LeaveryF/rv-cpu-expr/MemExt/rv32icpu.srcs/constrs_1/new/top_alu.xdc

set_property PACKAGE_PIN P28 [get_ports { A[7] }]
set_property IOSTANDARD LVCMOS18 [get_ports { A[7] }]
set_property PACKAGE_PIN P27 [get_ports { A[6] }]
set_property IOSTANDARD LVCMOS18 [get_ports { A[6] }]
set_property PACKAGE_PIN P26 [get_ports { A[5] }]
set_property IOSTANDARD LVCMOS18 [get_ports { A[5] }]
set_property PACKAGE_PIN T23 [get_ports { A[4] }]
set_property IOSTANDARD LVCMOS18 [get_ports { A[4] }]
set_property PACKAGE_PIN W23 [get_ports { A[3] }]
set_property IOSTANDARD LVCMOS18 [get_ports { A[3] }]
set_property PACKAGE_PIN T22 [get_ports { A[2] }]
set_property IOSTANDARD LVCMOS18 [get_ports { A[2] }]
set_property PACKAGE_PIN U22 [get_ports { A[1] }]
set_property IOSTANDARD LVCMOS18 [get_ports { A[1] }]
set_property PACKAGE_PIN T21 [get_ports { A[0] }]
set_property IOSTANDARD LVCMOS18 [get_ports { A[0] }]
set_property PACKAGE_PIN T27 [get_ports { B[7] }]
set_property IOSTANDARD LVCMOS18 [get_ports { B[7] }]
set_property PACKAGE_PIN T26 [get_ports { B[6] }]
set_property IOSTANDARD LVCMOS18 [get_ports { B[6] }]
set_property PACKAGE_PIN T25 [get_ports { B[5] }]
set_property IOSTANDARD LVCMOS18 [get_ports { B[5] }]
set_property PACKAGE_PIN R30 [get_ports { B[4] }]
set_property IOSTANDARD LVCMOS18 [get_ports { B[4] }]
set_property PACKAGE_PIN R29 [get_ports { B[3] }]
set_property IOSTANDARD LVCMOS18 [get_ports { B[3] }]
set_property PACKAGE_PIN R28 [get_ports { B[2] }]
set_property IOSTANDARD LVCMOS18 [get_ports { B[2] }]
set_property PACKAGE_PIN R26 [get_ports { B[1] }]
set_property IOSTANDARD LVCMOS18 [get_ports { B[1] }]
set_property PACKAGE_PIN P29 [get_ports { B[0] }]
set_property IOSTANDARD LVCMOS18 [get_ports { B[0] }]
set_property PACKAGE_PIN T30 [get_ports { ALUControl[1] }]
set_property IOSTANDARD LVCMOS18 [get_ports { ALUControl[1] }]
set_property PACKAGE_PIN T28 [get_ports { ALUControl[0] }]
set_property IOSTANDARD LVCMOS18 [get_ports { ALUControl[0] }]
set_property PACKAGE_PIN E29 [get_ports { Result[7] }]
set_property IOSTANDARD LVCMOS18 [get_ports { Result[7] }]
set_property PACKAGE_PIN G25 [get_ports { Result[6] }]
set_property IOSTANDARD LVCMOS18 [get_ports { Result[6] }]
set_property PACKAGE_PIN F26 [get_ports { Result[5] }]
set_property IOSTANDARD LVCMOS18 [get_ports { Result[5] }]
set_property PACKAGE_PIN C26 [get_ports { Result[4] }]
set_property IOSTANDARD LVCMOS18 [get_ports { Result[4] }]
set_property PACKAGE_PIN E25 [get_ports { Result[3] }]
set_property IOSTANDARD LVCMOS18 [get_ports { Result[3] }]
set_property PACKAGE_PIN C24 [get_ports { Result[2] }]
set_property IOSTANDARD LVCMOS18 [get_ports { Result[2] }]
set_property PACKAGE_PIN E24 [get_ports { Result[1] }]
set_property IOSTANDARD LVCMOS18 [get_ports { Result[1] }]
set_property PACKAGE_PIN G24 [get_ports { Result[0] }]
set_property IOSTANDARD LVCMOS18 [get_ports { Result[0] }]
set_property PACKAGE_PIN G23 [get_ports { N }]
set_property IOSTANDARD LVCMOS18 [get_ports { N }]
set_property PACKAGE_PIN E23 [get_ports { Z }]
set_property IOSTANDARD LVCMOS18 [get_ports { Z }]
set_property PACKAGE_PIN D24 [get_ports { V }]
set_property IOSTANDARD LVCMOS18 [get_ports { V }]
set_property PACKAGE_PIN C25 [get_ports { C }]
set_property IOSTANDARD LVCMOS18 [get_ports { C }]

set_property CLOCK_DEDICATED_ROUTE FALSE [get_nets ALUControl[1]]
