LeaveryF/rv-cpu-expr/alu/rv32icpu.srcs/sources_1/new/adder.sv

`timescale 1ns / 1ps
//////////////////////////////////////////////////////////////////////////////////
// Company: 
// Engineer: 
// 
// Create Date: 02/19/2025 11:28:42 AM
// Design Name: 
// Module Name: adder
// Project Name: 
// Target Devices: 
// Tool Versions: 
// Description: 
// 
// Dependencies: 
// 
// Revision:
// Revision 0.01 - File Created
// Additional Comments:
// 
//////////////////////////////////////////////////////////////////////////////////


module adder(
    input  logic a,
    input  logic b,
    input  logic cin,
    output logic sum,
    output logic cout
);
endmodule
