LeaveryF/rv-cpu-expr/alu/rv32icpu.srcs/sources_1/new/multipler32.sv

`timescale 1ns / 1ps
//////////////////////////////////////////////////////////////////////////////////
// Company: 
// Engineer: 
// 
// Create Date: 02/19/2025 11:18:46 AM
// Design Name: 
// Module Name: multipler32
// Project Name: 
// Target Devices: 
// Tool Versions: 
// Description: 
// 
// Dependencies: 
// 
// Revision:
// Revision 0.01 - File Created
// Additional Comments:
// 
//////////////////////////////////////////////////////////////////////////////////


module multipler32(
    input  logic [31:0] a,
    input  logic [31:0] b,
    output logic [63:0] p
);
endmodule
