LeaveryF/rv-cpu-expr/(commit log)

2026-06-15 verification task
    [图5-11 miniRV-1指令总表.xlsx, 图5-17 ALU操作编码表.xlsx, 图5-21 数据通路_图5-24 控制信号表.xlsx]
2026-06-16 expr-3: fix power template format (space before colon)
2026-06-16 expr-3: use synthesize_fp_rail for power plan to avoid geometry assertion
2026-06-16 expr-3: simplify floorplan - skip complex power ring, use rail routing only
2026-06-16 expr-3: use legacy placement flow to avoid place_opt ICC2 bug
2026-06-16 expr-3: simplify place/cts — remove psynopt timing opt from placement, keep CTS basic
2026-06-17 expr-3: update README with view_layout.sh and CEL stage reference
2026-06-17 expr-3: fix view_layout.sh — use absolute MW lib path, add existence check
2026-06-17 expr-3: reorder layout view stages in README by physical design flow
